Riyu-D1/Knoll/design/renders/droid-v0/img/comparison.png

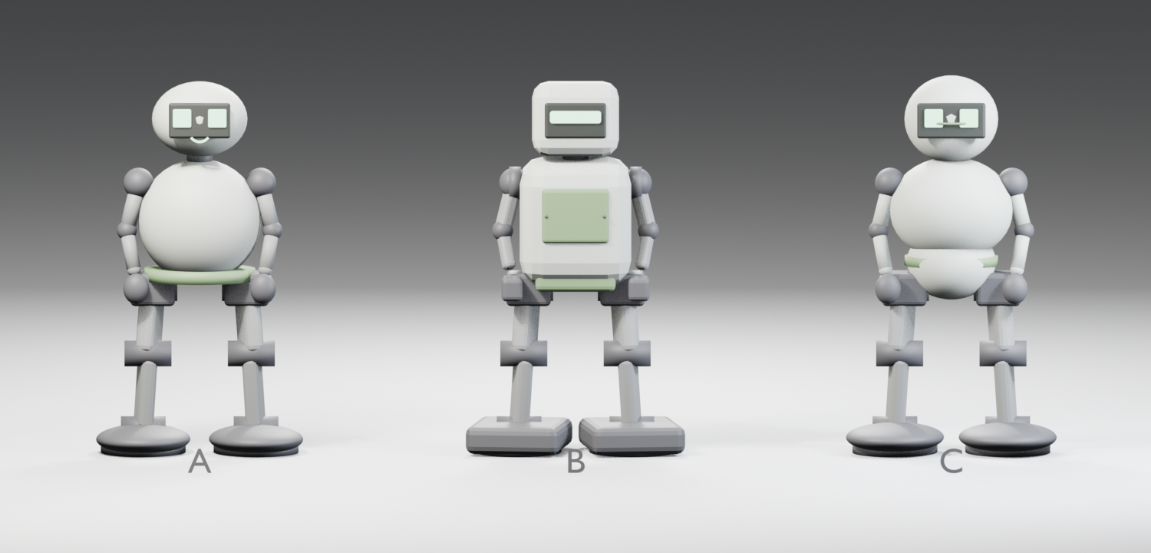
design/renders/droid-v0/img/comparison.png
