Riyu-D1/Knoll/design/renders/shell-v0/img/detail-eyes.png

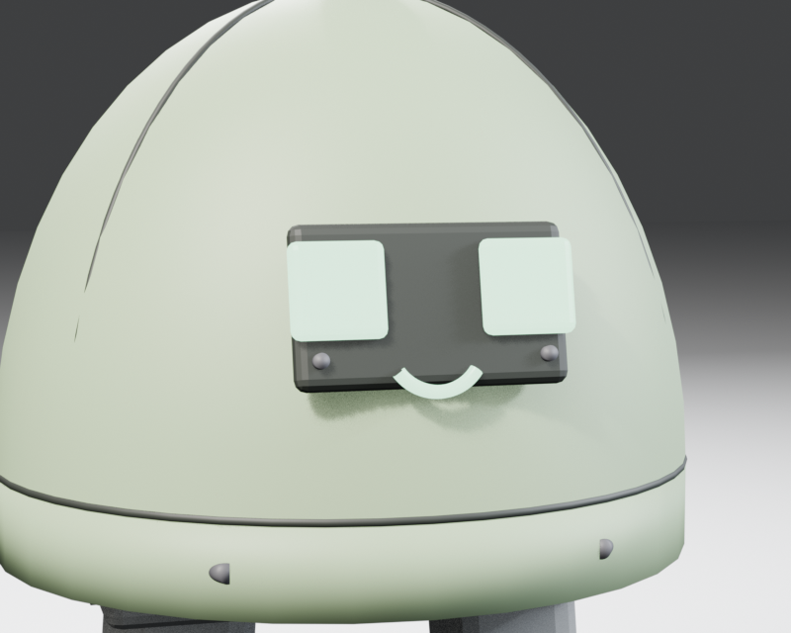
design/renders/shell-v0/img/detail-eyes.png
