Riyu-D1/Knoll/design/renders/droid-v0/img/colorways.png

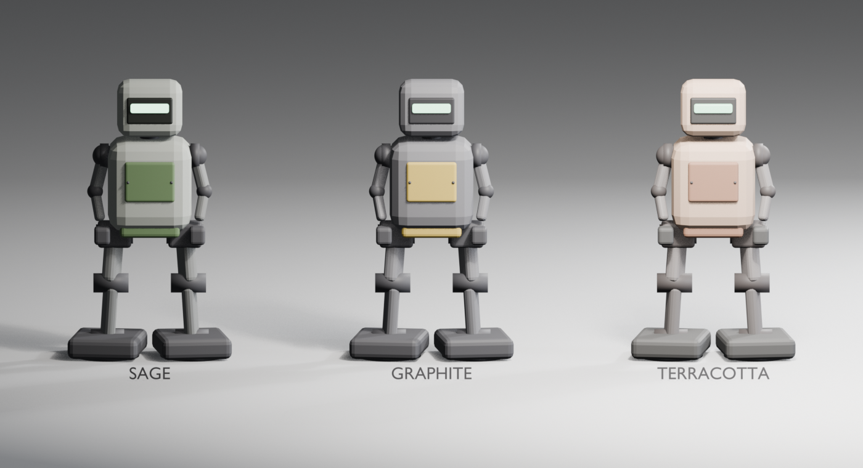
design/renders/droid-v0/img/colorways.png
