Riyu-D1/Knoll/design/renders/droid-v0/img/detail-arm.png

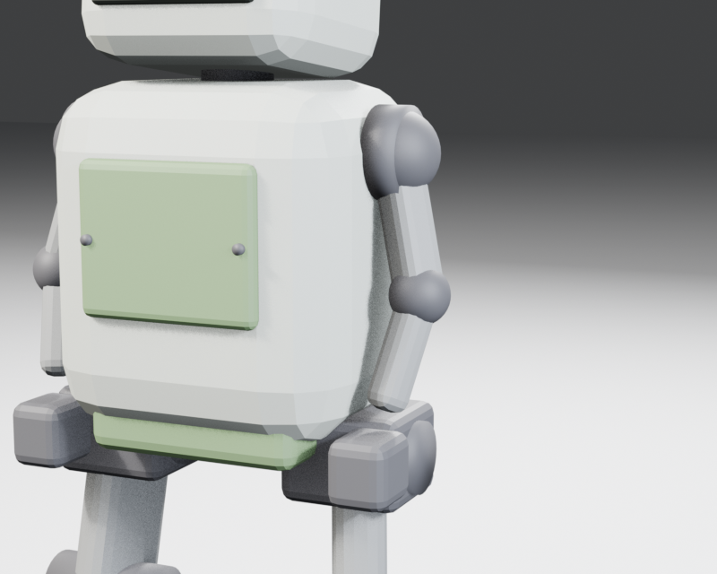
design/renders/droid-v0/img/detail-arm.png
