Riyu-D1/Knoll/design/renders/droid-v0/img/detail-face.png

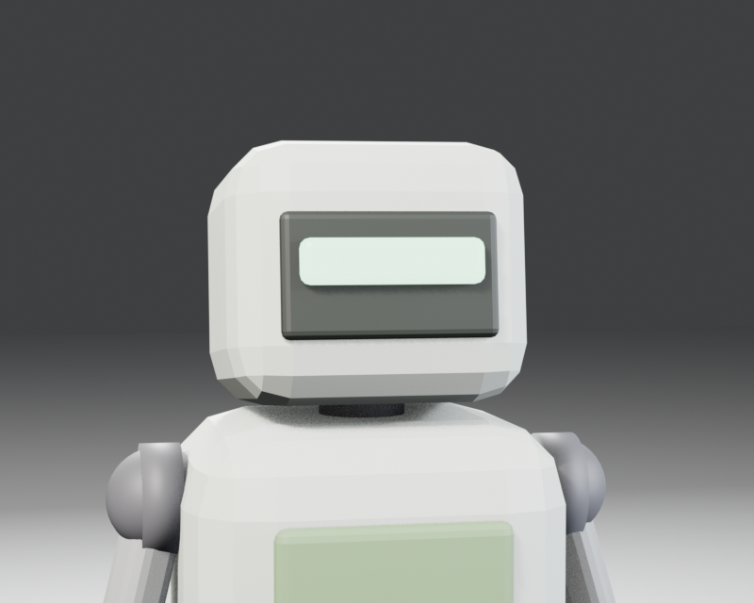
design/renders/droid-v0/img/detail-face.png
