Riyu-D1/Knoll/design/renders/droid-v0/img/detail-rear.png

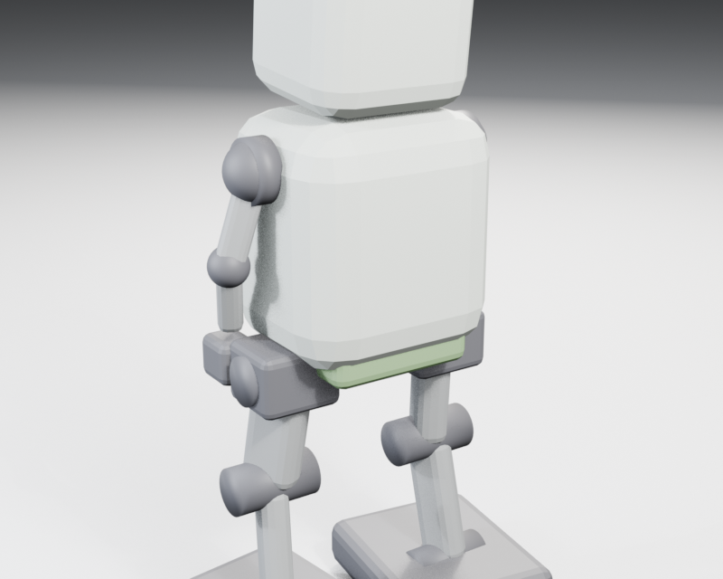
design/renders/droid-v0/img/detail-rear.png
