Riyu-D1/Knoll/design/renders/droid-v0/img/exploded-b.png

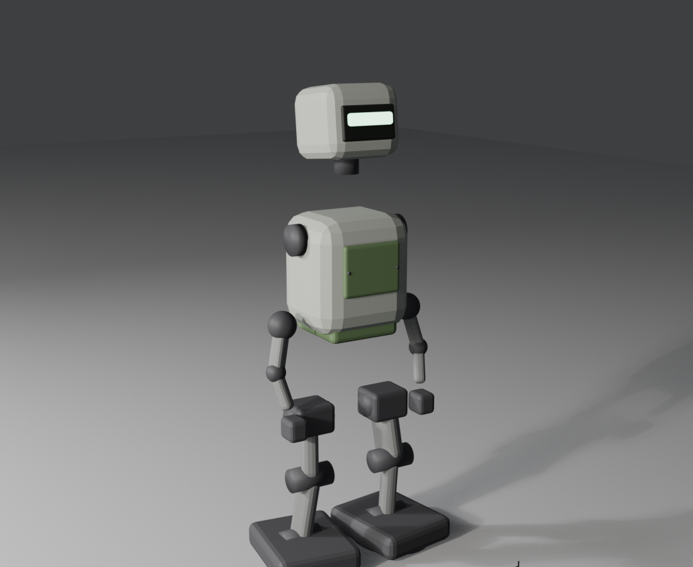
design/renders/droid-v0/img/exploded-b.png
