Riyu-D1/Knoll/design/renders/droid-v0/img/hero-variant-a.png

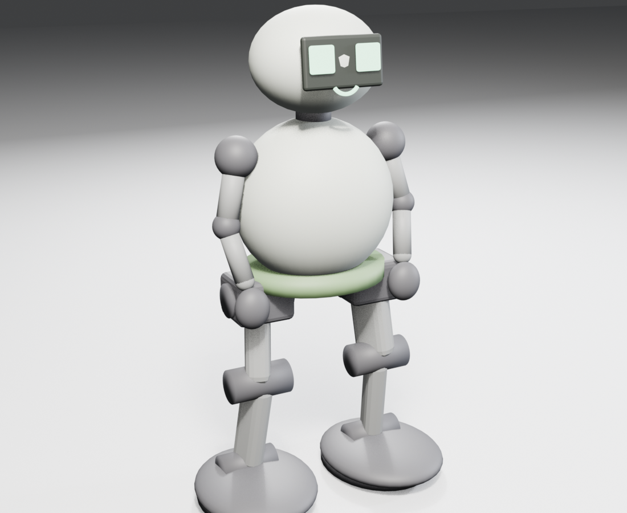
design/renders/droid-v0/img/hero-variant-a.png
