Riyu-D1/Knoll/design/renders/droid-v0/img/hero-variant-b.png

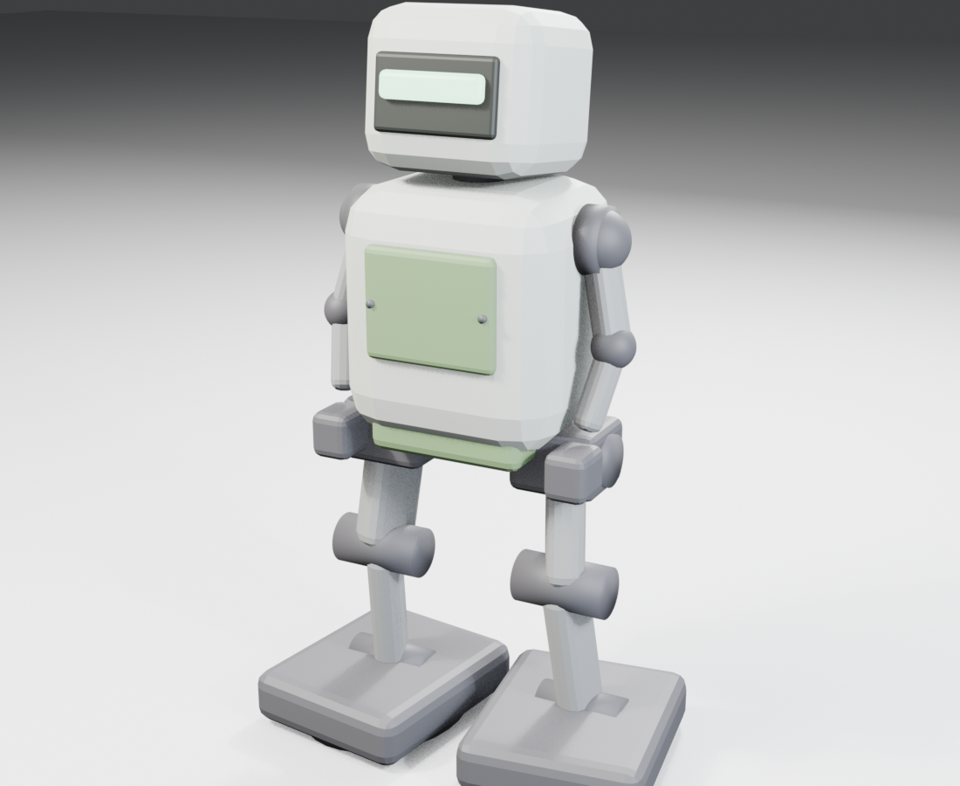
design/renders/droid-v0/img/hero-variant-b.png
