Riyu-D1/Knoll/design/renders/droid-v0/img/ortho-a-34.png

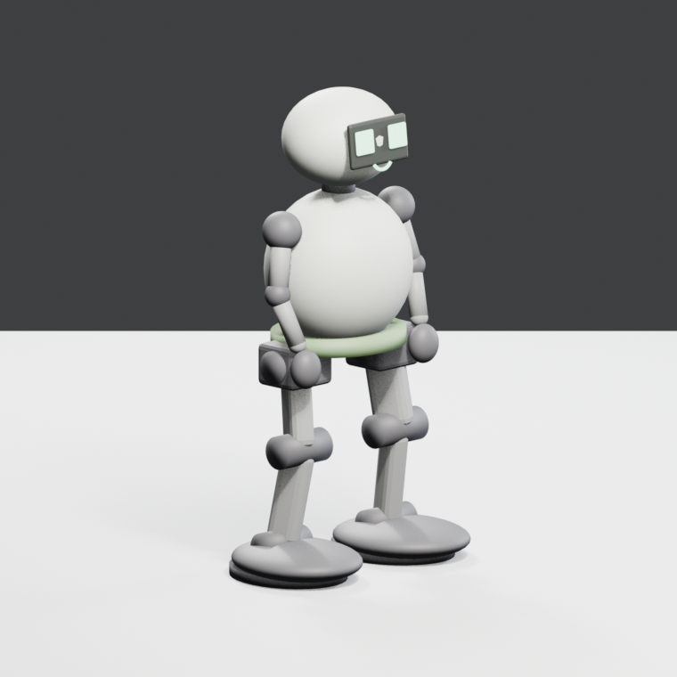
design/renders/droid-v0/img/ortho-a-34.png
