Riyu-D1/Knoll/design/renders/droid-v0/img/ortho-a-front.png

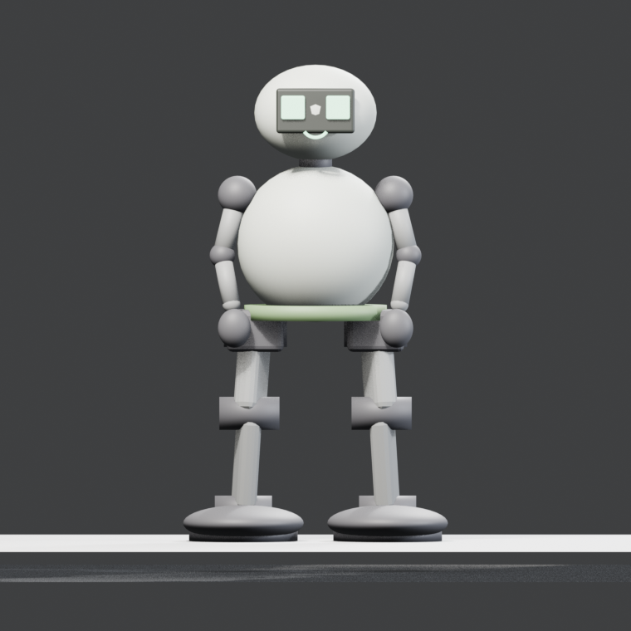
design/renders/droid-v0/img/ortho-a-front.png
