Riyu-D1/Knoll/design/renders/droid-v0/img/ortho-b-34.png

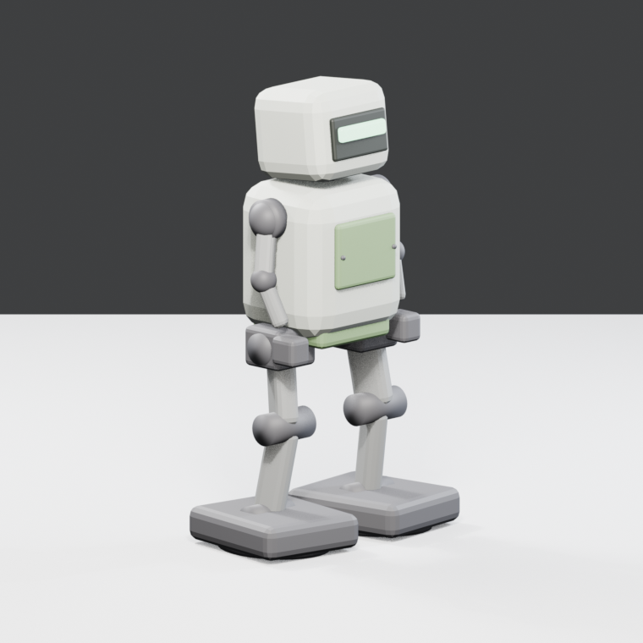
design/renders/droid-v0/img/ortho-b-34.png
