Riyu-D1/Knoll/design/renders/droid-v0/img/ortho-b-side.png

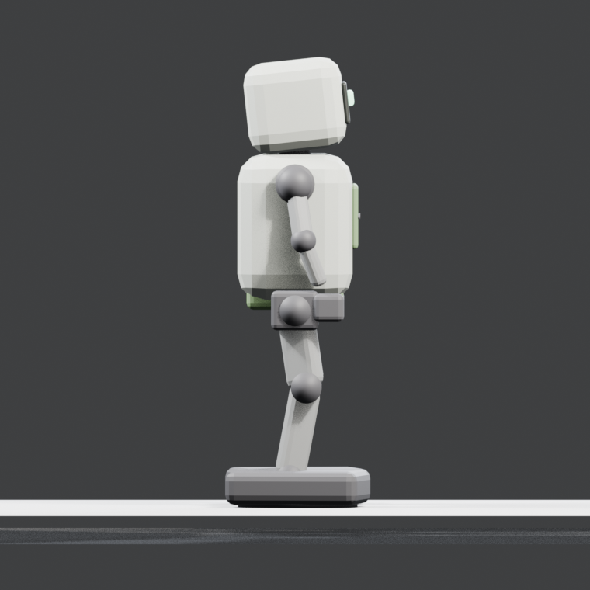
design/renders/droid-v0/img/ortho-b-side.png
