Riyu-D1/Knoll/design/renders/droid-v0/img/ortho-c-side.png

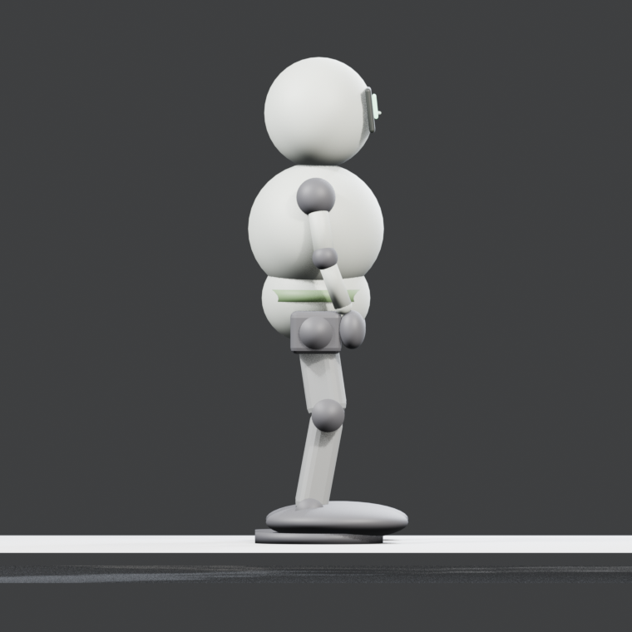
design/renders/droid-v0/img/ortho-c-side.png
