Riyu-D1/Knoll/design/renders/shell-v0/img/detail-seam.png

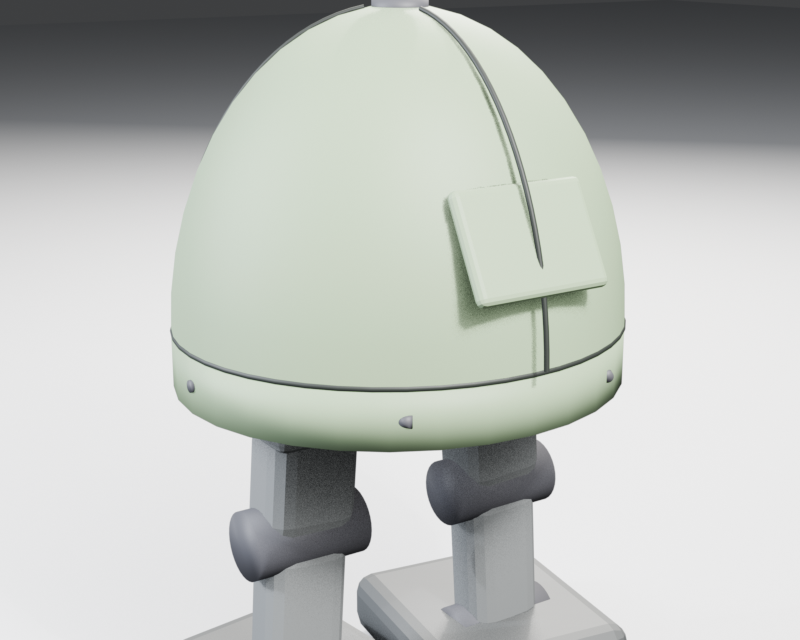
design/renders/shell-v0/img/detail-seam.png
