Riyu-D1/Knoll/design/renders/shell-v0/img/detail-topper.png

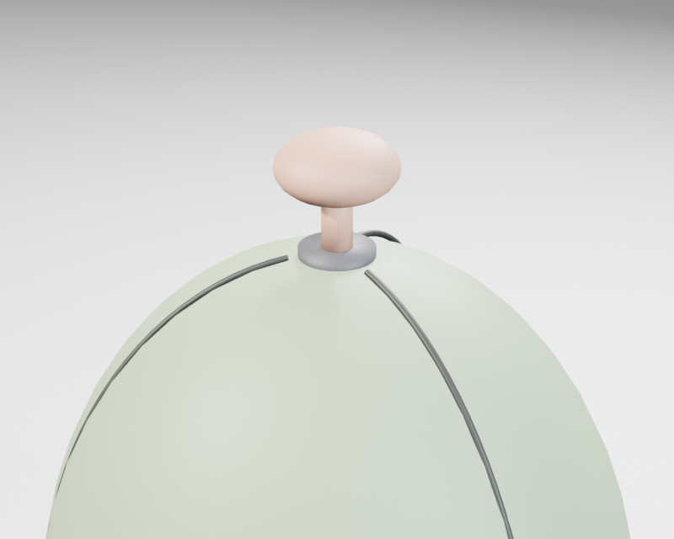
design/renders/shell-v0/img/detail-topper.png
