Riyu-D1/Knoll/(list of files, cad)

Other CAD files:
design/renders/droid-v0/knoll-droid-v0.blend
design/renders/shell-v0/knoll-shell-v0.blend
