Riyu-D1/Knoll/(commit log)

2026-10-26 Knoll Mk1: Phase-1 research & engineering specification
    Complete R&D package for an original open-hardware DIY mascot robot:
    a ~27cm dome-shelled biped (10 DOF, 5/leg) targeting Microduck-class
    capability (RL locomotion + staged self-recovery) as a fully open,
    repairable build at ~GBP 215-360.
    - Reference analysis of Pollen/HF Microduck (verified, source-cited)
    - 3 mascot concepts + scoring -> Knoll selected
    - Mechanical architecture (joint table, dimensions, assembly tree)
    - Actuator study with torque calcs (Waveshare ST3020 on direct 2S)
    - Electronics: RP2350 safety MCU + Pi Zero 2W policy host, KCB-1 PCB spec
    - Control/recovery: MuJoCo + BAM + ONNX, staged KFB->learned plan
    - Software ar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
    [master-bom.csv]
2026-10-26 Shell v0: first 3D visual prototype — three shell variants + renders
    Parametric Blender scene (build_scene.py) modelling the Knoll Mk1
    exterior at locked brief dimensions: 170x160x135 dome on the 10-DOF
    proxy leg platform (~275mm apex). Three directions: A Soft Moss,
    B Modular Terrarium (recommended), C Sculptural Knoll.
    21 EEVEE renders: comparison, heroes, ortho sheets, exploded service
    view, colourways, details. DESIGN-REVIEW.md records assumptions vs
    engineering constraints and open conflicts.
    Concept visualisation only — not validated mechanical geometry.
    Generated with [Devin](https://devin.ai)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
    [knoll-shell-v0.blend]
2026-10-26 Droid v0: agile-biped redirect — 15-DOF concepts + renders
    User-approved pivot from dome-shell to agile biped-droid archetype
    after shell-v0 review: 5/leg + 2/arm (pitch+roll) + 1 neck (pitch)
    = 15 DOF. Parametric Blender scene, 3 variants (A Field Buddy,
    B Service Frame, C Apex), 21 renders, editable .blend.
    v1.1 doc overlays flag the engineering consequence honestly:
    mass ~1.09kg -> ~1.4kg breaches the knee torque gate; actuator
    study marked stale pending re-validation. Concept visualisation
    only — not validated geometry, get-up capability not yet simulated.
    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
    [knoll-droid-v0.blend]
